antmicro/audio-latency-tester-board/assets/previews/layer1.png

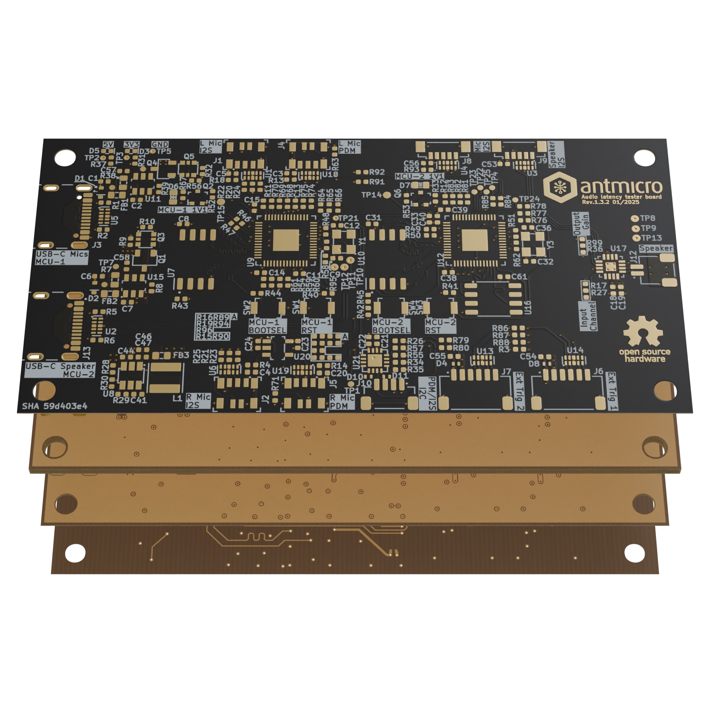
assets/previews/layer1.png
