antmicro/audio-latency-tester-board/assets/previews/layer2.png

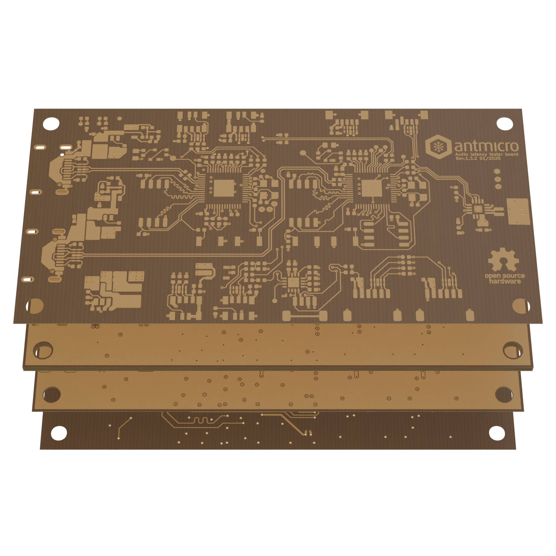
assets/previews/layer2.png
