antmicro/audio-latency-tester-board/assets/previews/layer3.png

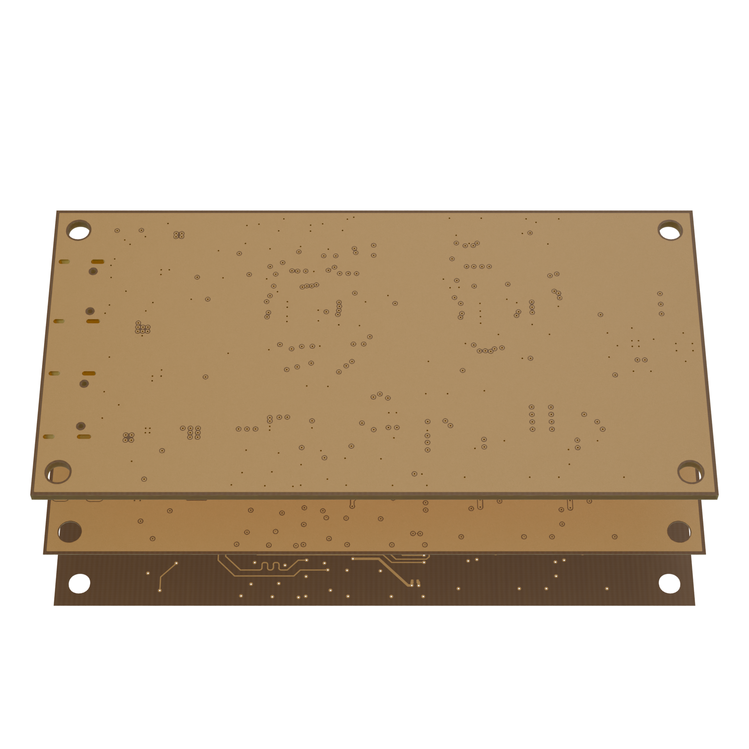
assets/previews/layer3.png
