antmicro/audio-latency-tester-board/assets/previews/layer3.webp

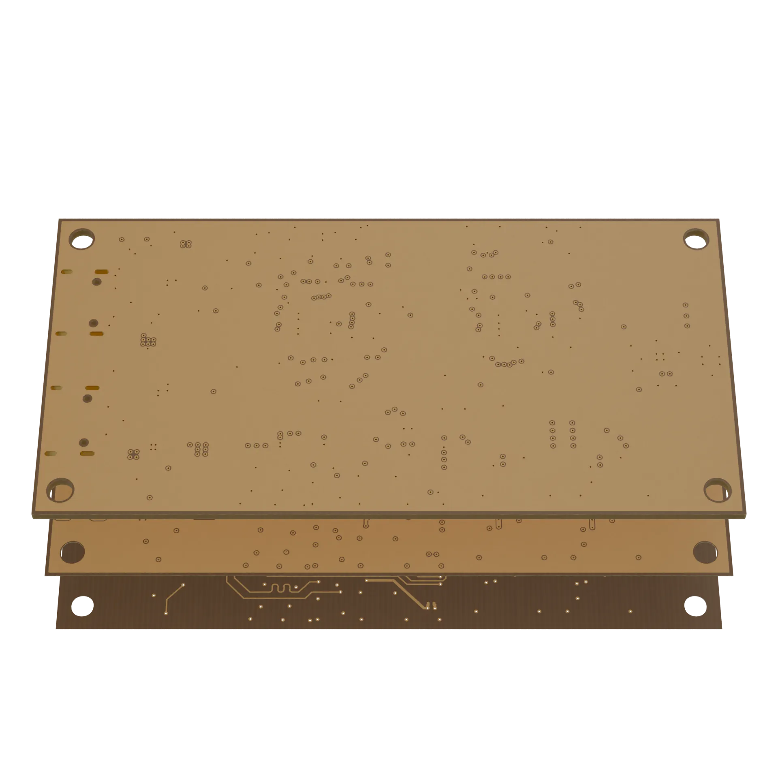
assets/previews/layer3.webp
