antmicro/audio-latency-tester-board/assets/previews/layer3_thumbnail.png

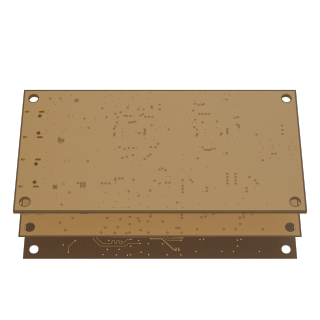
assets/previews/layer3_thumbnail.png
