antmicro/audio-latency-tester-board/assets/previews/layer4.png

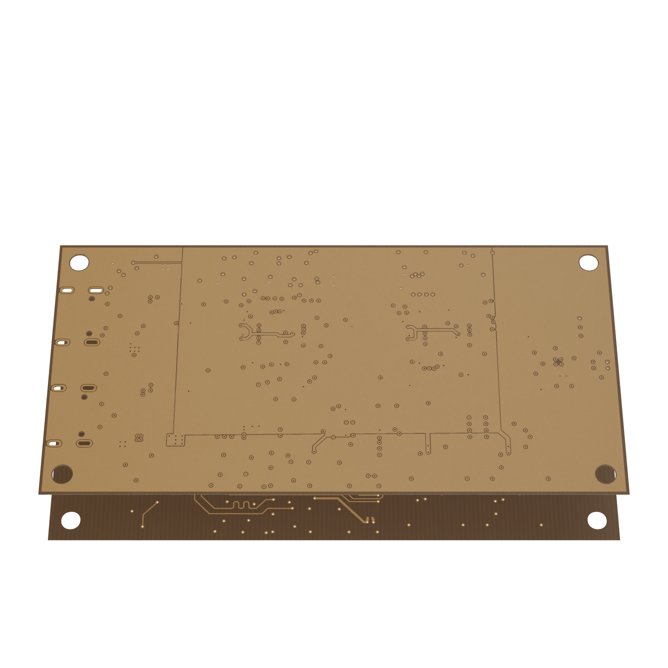
assets/previews/layer4.png
