antmicro/audio-latency-tester-board/assets/previews/layer4_thumbnail.webp

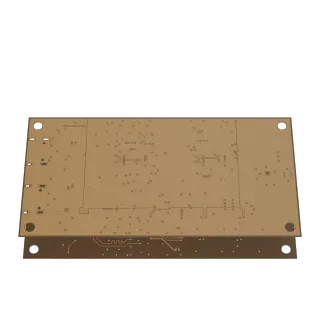
assets/previews/layer4_thumbnail.webp
