antmicro/audio-latency-tester-board/assets/previews/layer5.png

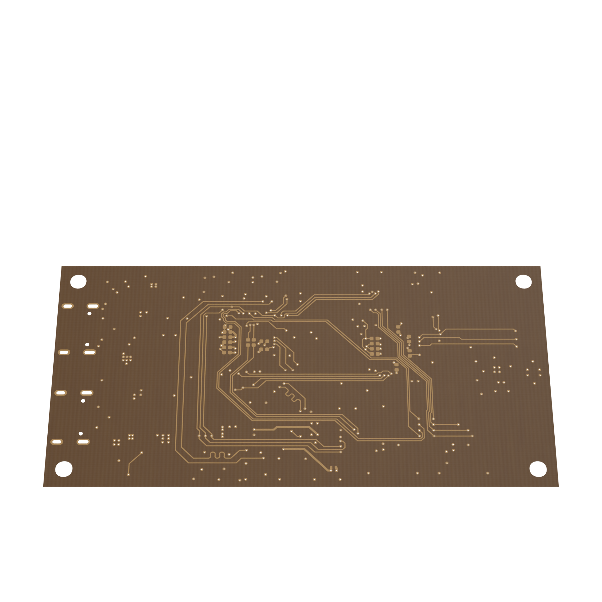
assets/previews/layer5.png
