antmicro/audio-latency-tester-board/assets/previews/leftB.png

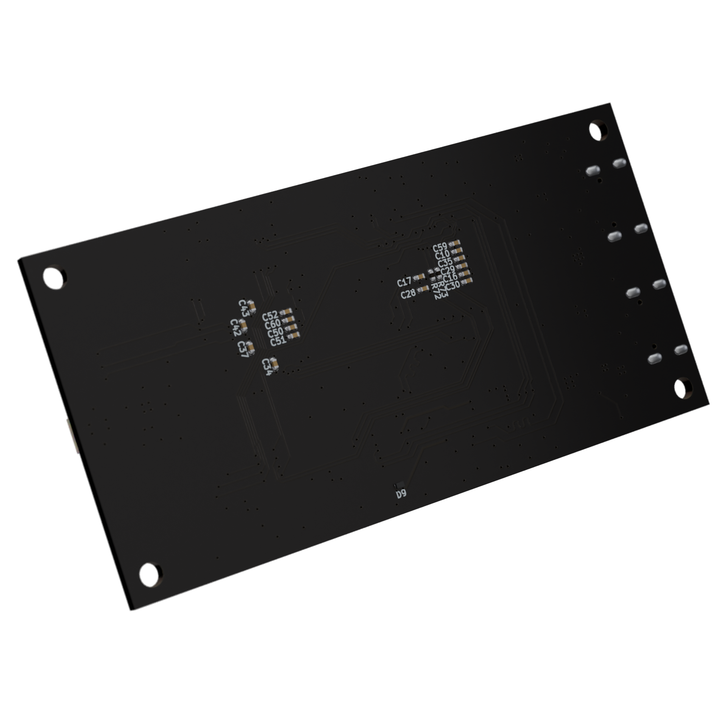
assets/previews/leftB.png
