antmicro/audio-latency-tester-board/assets/previews/leftT.png

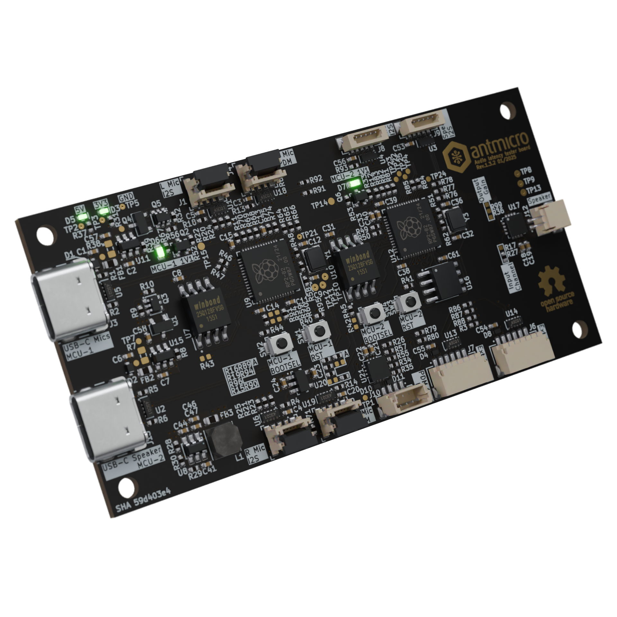
assets/previews/leftT.png
