antmicro/audio-latency-tester-board/assets/previews/orthoB.png

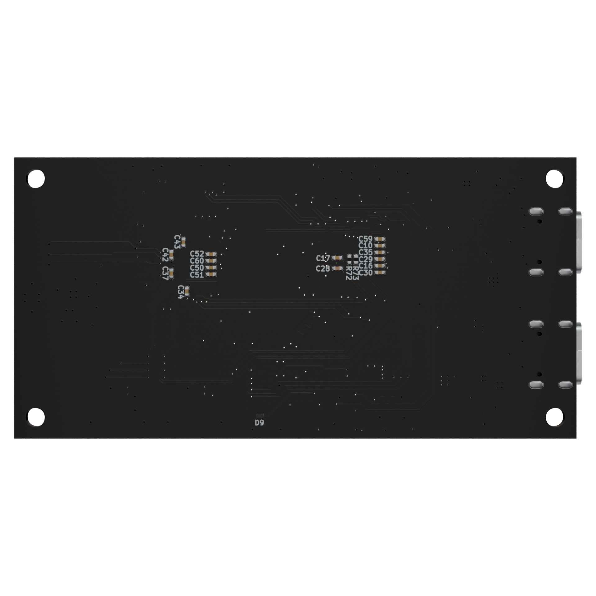
assets/previews/orthoB.png
