antmicro/audio-latency-tester-board/assets/previews/rightB.png

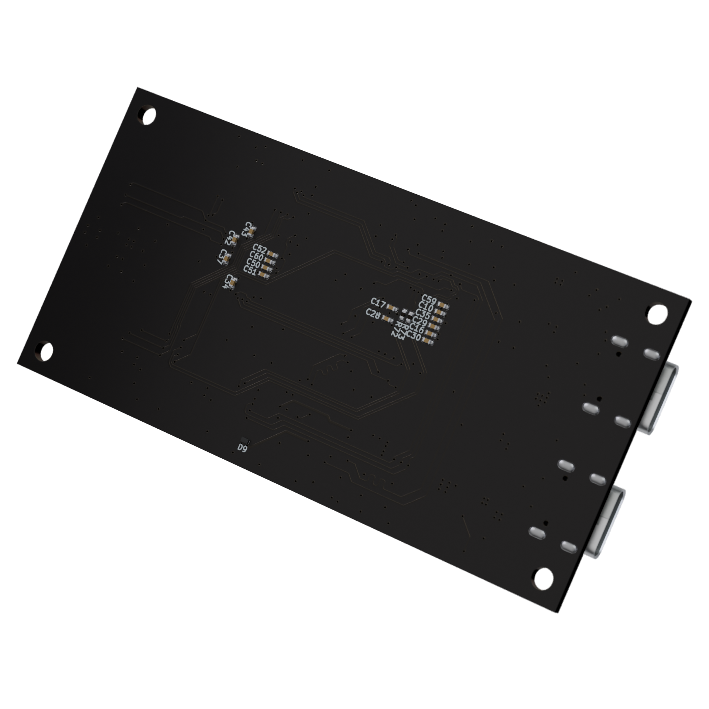
assets/previews/rightB.png
