antmicro/audio-latency-tester-board/assets/previews/rightT.png

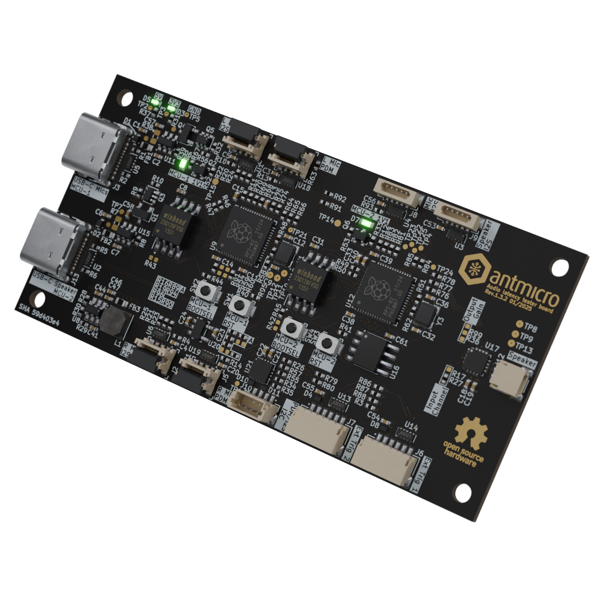
assets/previews/rightT.png
