antmicro/audio-latency-tester-board/assets/wireframe/wireframe_wireframe_dimensions.png

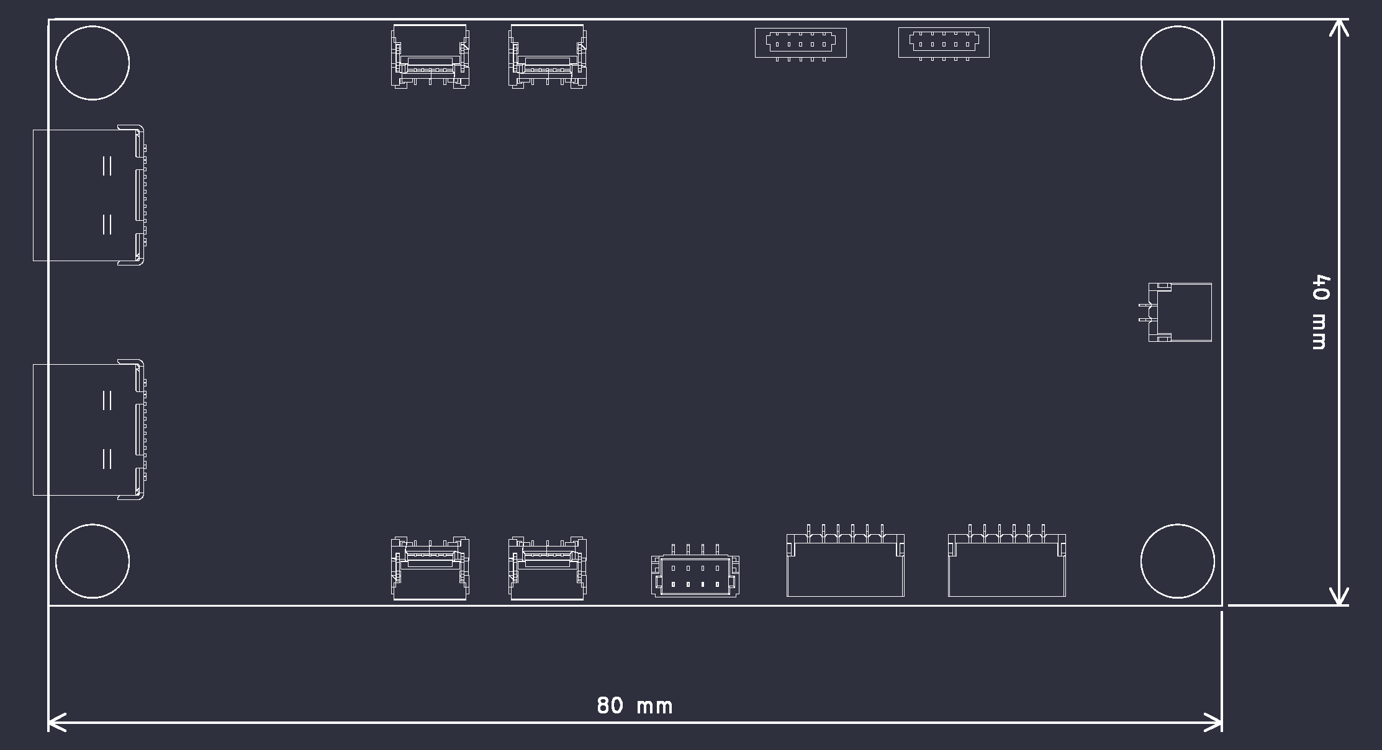
assets/wireframe/wireframe_wireframe_dimensions.png
