antmicro/audio-latency-tester-board/doc/audio-latency-tester-board-schematic.pdf

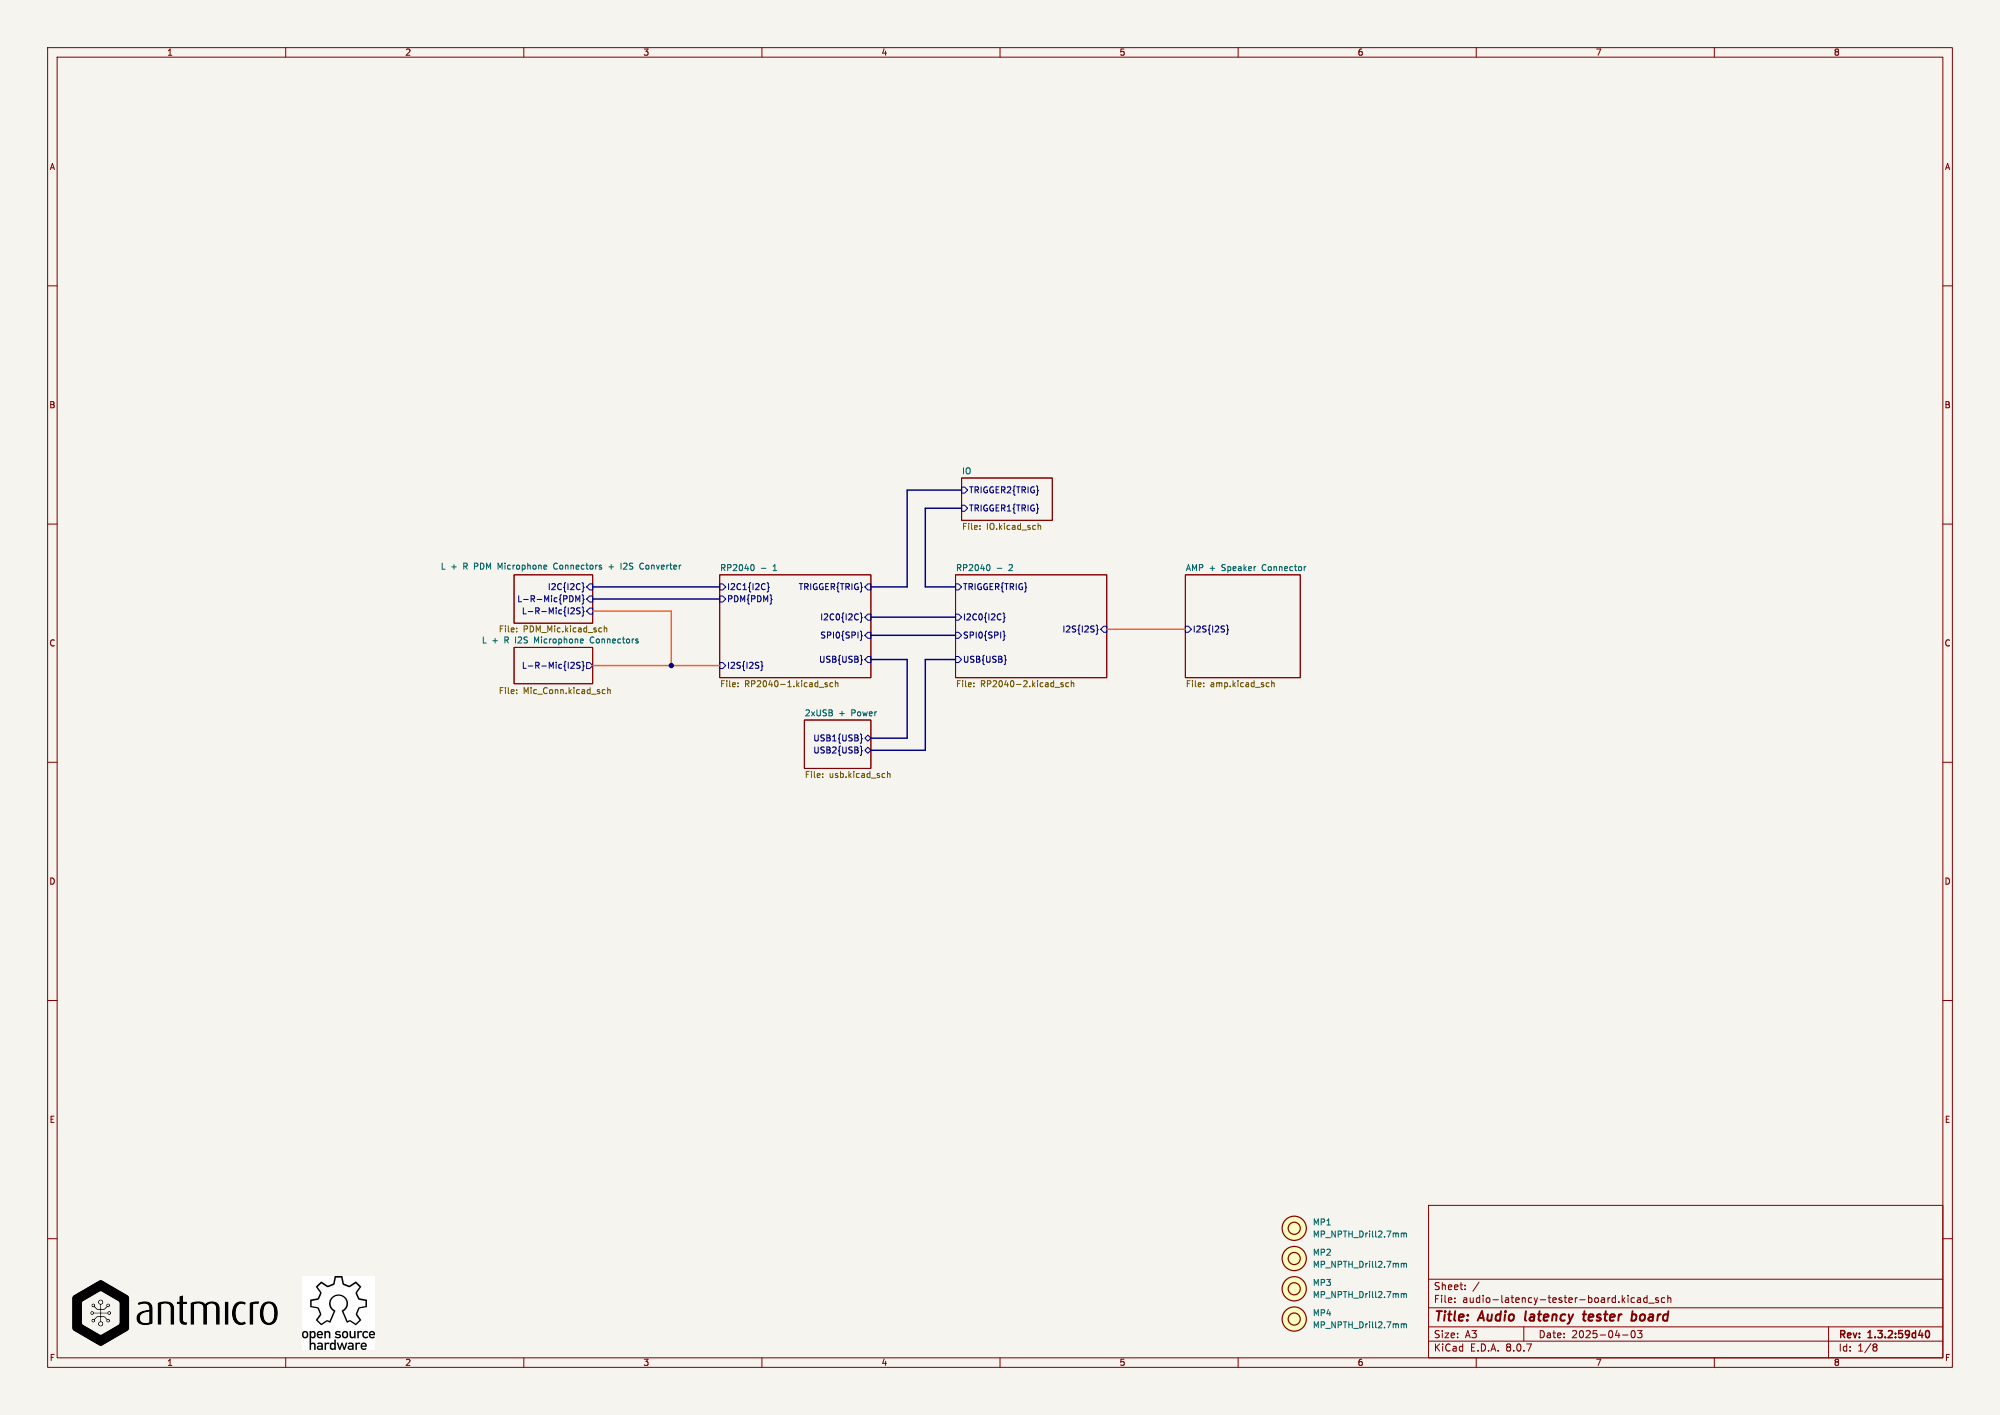
[picture p19: page 1]

I2S{I2S} AMP + Speaker Connector File: amp.kicad_sch

USB1{USB} 2xUSB + Power File: usb.kicad_sch

File: audio-latency-tester-board.kicad_sch Sheet: /
Id: 1/8 Title: Audio latency tester board

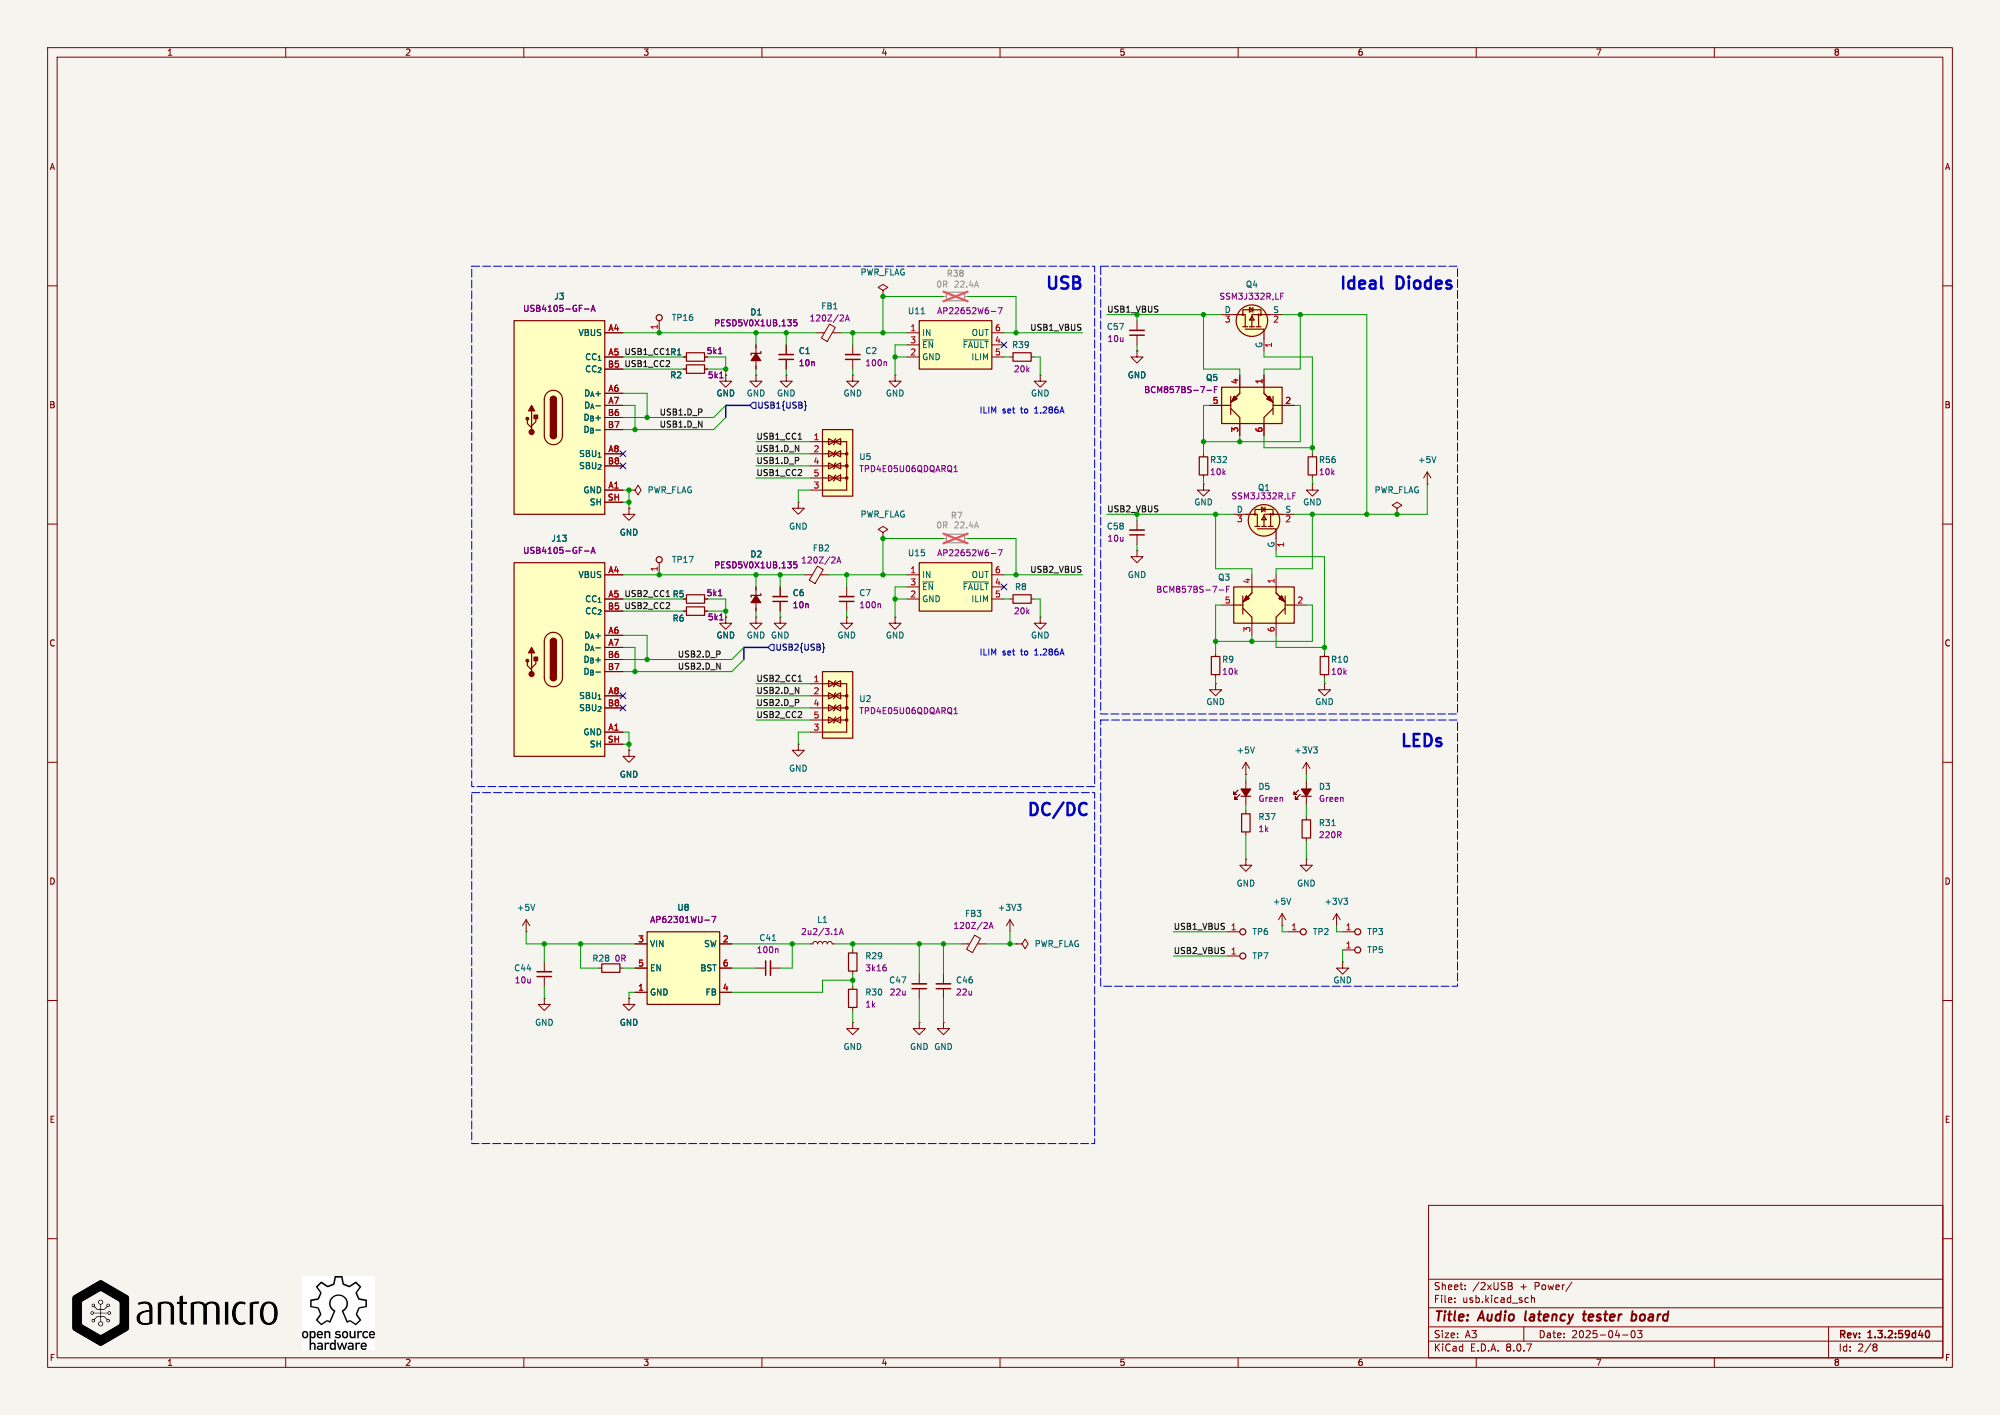
[picture p20: page 2]

PWR_FLAG
ILIM set to 1.286A USB

J13 USB4105-GF-A GND A1 VBUS A4 CC_{1}A5 D_{A}+A6 D_{A}-A7 SBU_{1}A8 CC_{2}B5 D_{B}+B6 D_{B}-B7 SBU_{2}B8 SH SH

J3 USB4105-GF-A GND A1 VBUS A4 CC_{1}A5 D_{A}+A6 D_{A}-A7 SBU_{1}A8 CC_{2}B5 D_{B}+B6 D_{B}-B7 SBU_{2}B8 SH SH

J13 USB4105-GF-A GND A1 VBUS A4 CC_{1}A5 D_{A}+A6 D_{A}-A7 SBU_{1}A8 CC_{2}B5 D_{B}+B6 D_{B}-B7 SBU_{2}B8 SH SHGND

+3V3 GND A1 VBUS A4 CC_{1}A5 D_{A}+A6 D_{A}-A7 SBU_{1}A8 CC_{2}B5 D_{B}+B6 D_{B}-B7 SBU_{2}B8 SH SH

Id: 2/8 Title: Audio latency tester board

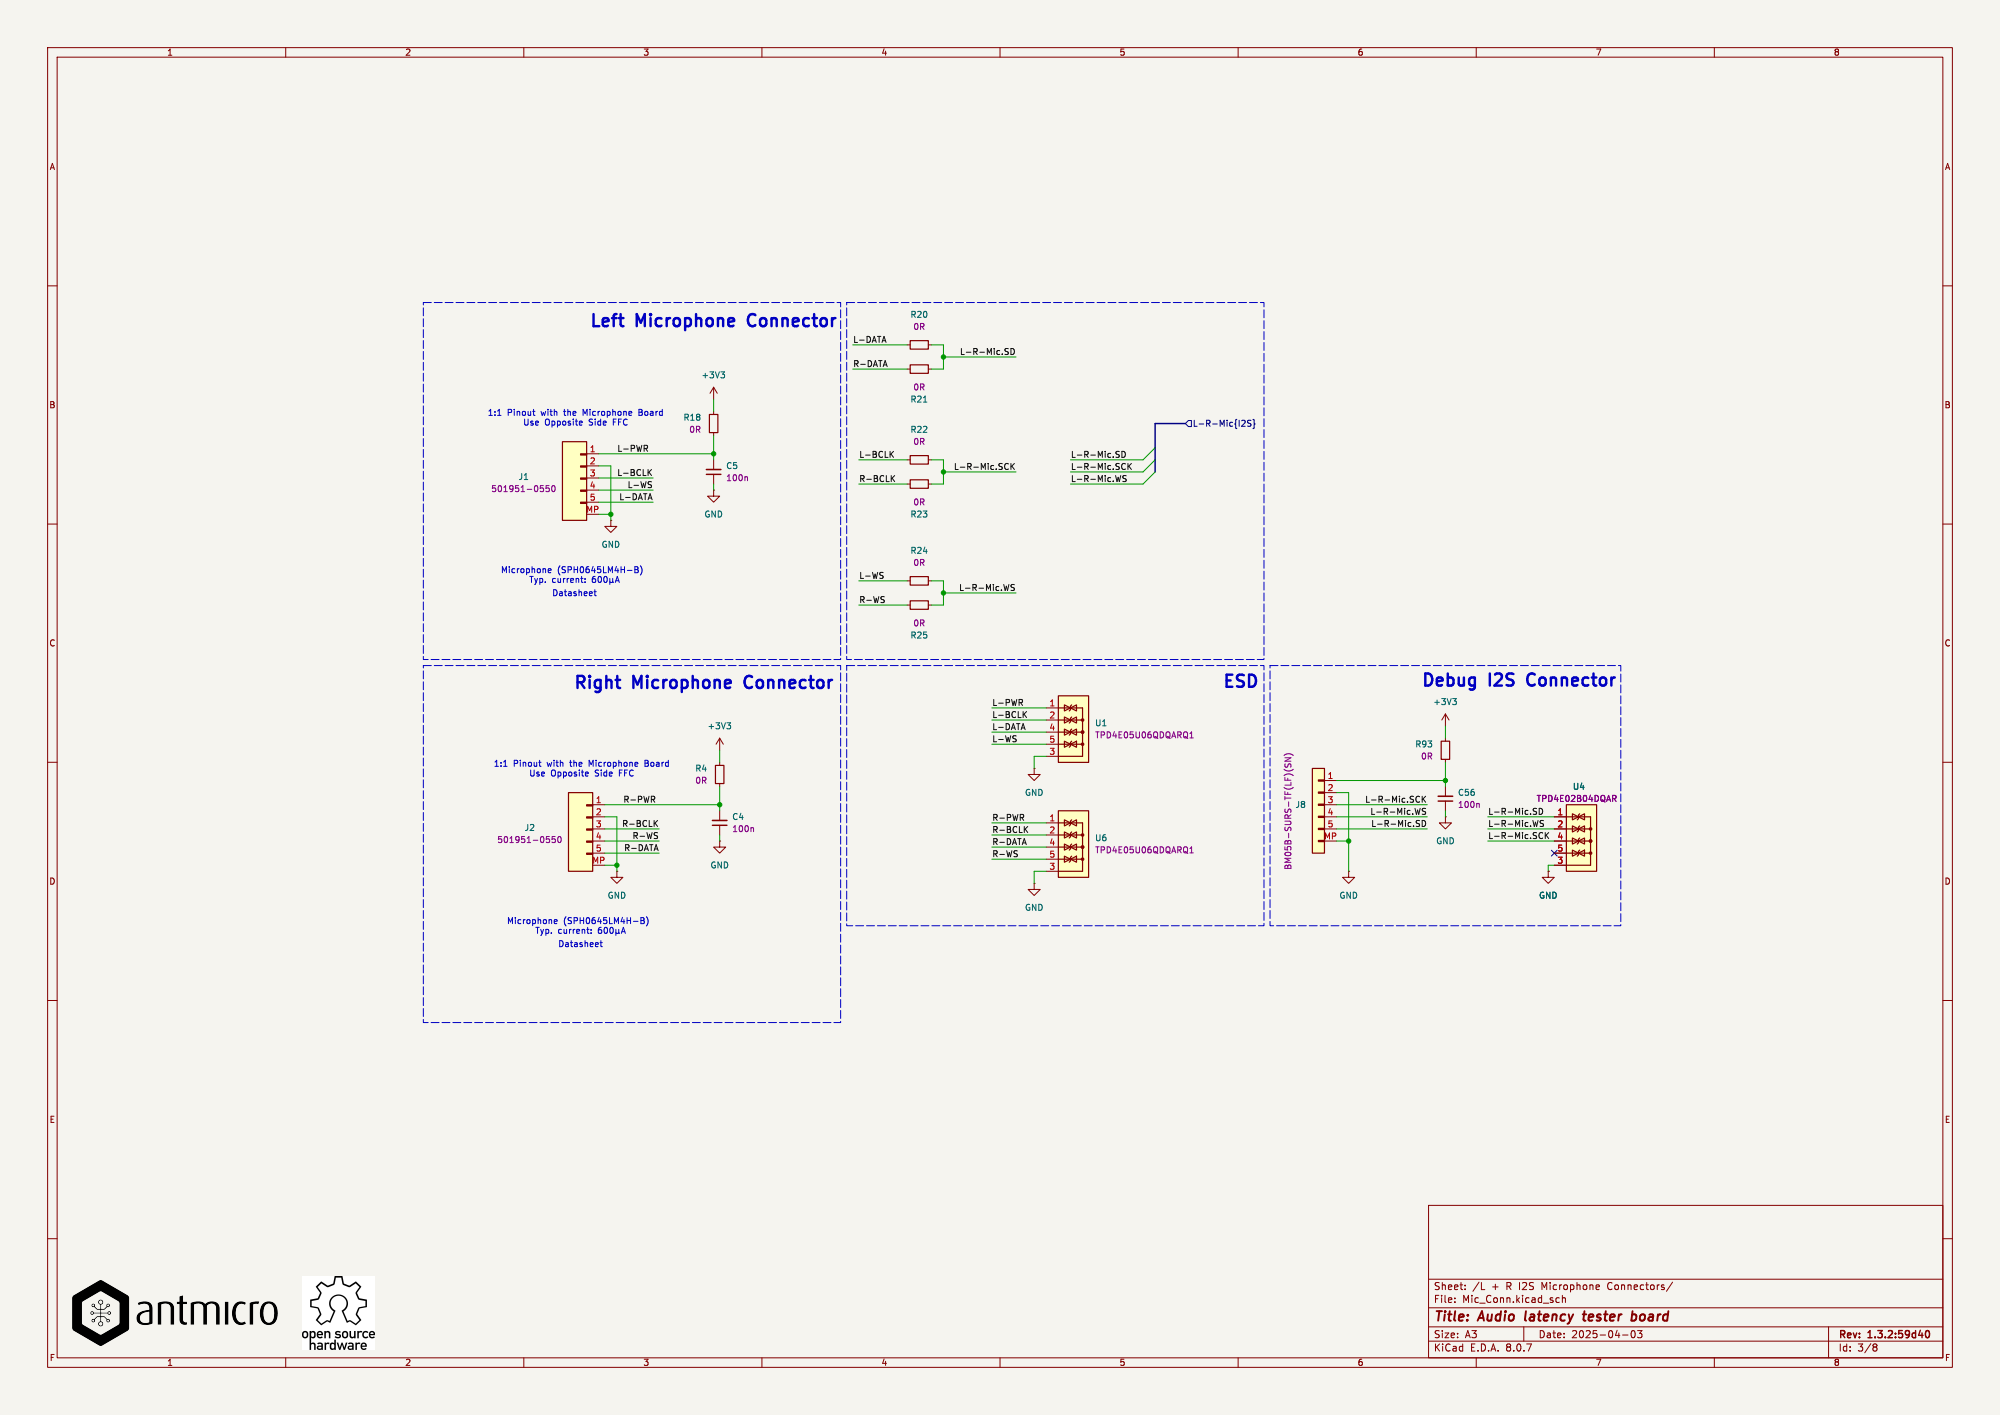
[picture p21: page 3]

L-R-Mic.SD
L-R-Mic.SCKR-DATA R-PWR

L-R-Mic.WS R-WS R-BCLK

L-R-Mic.WS Debug I2S Connector

Id: 3/8 Title: Audio latency tester board

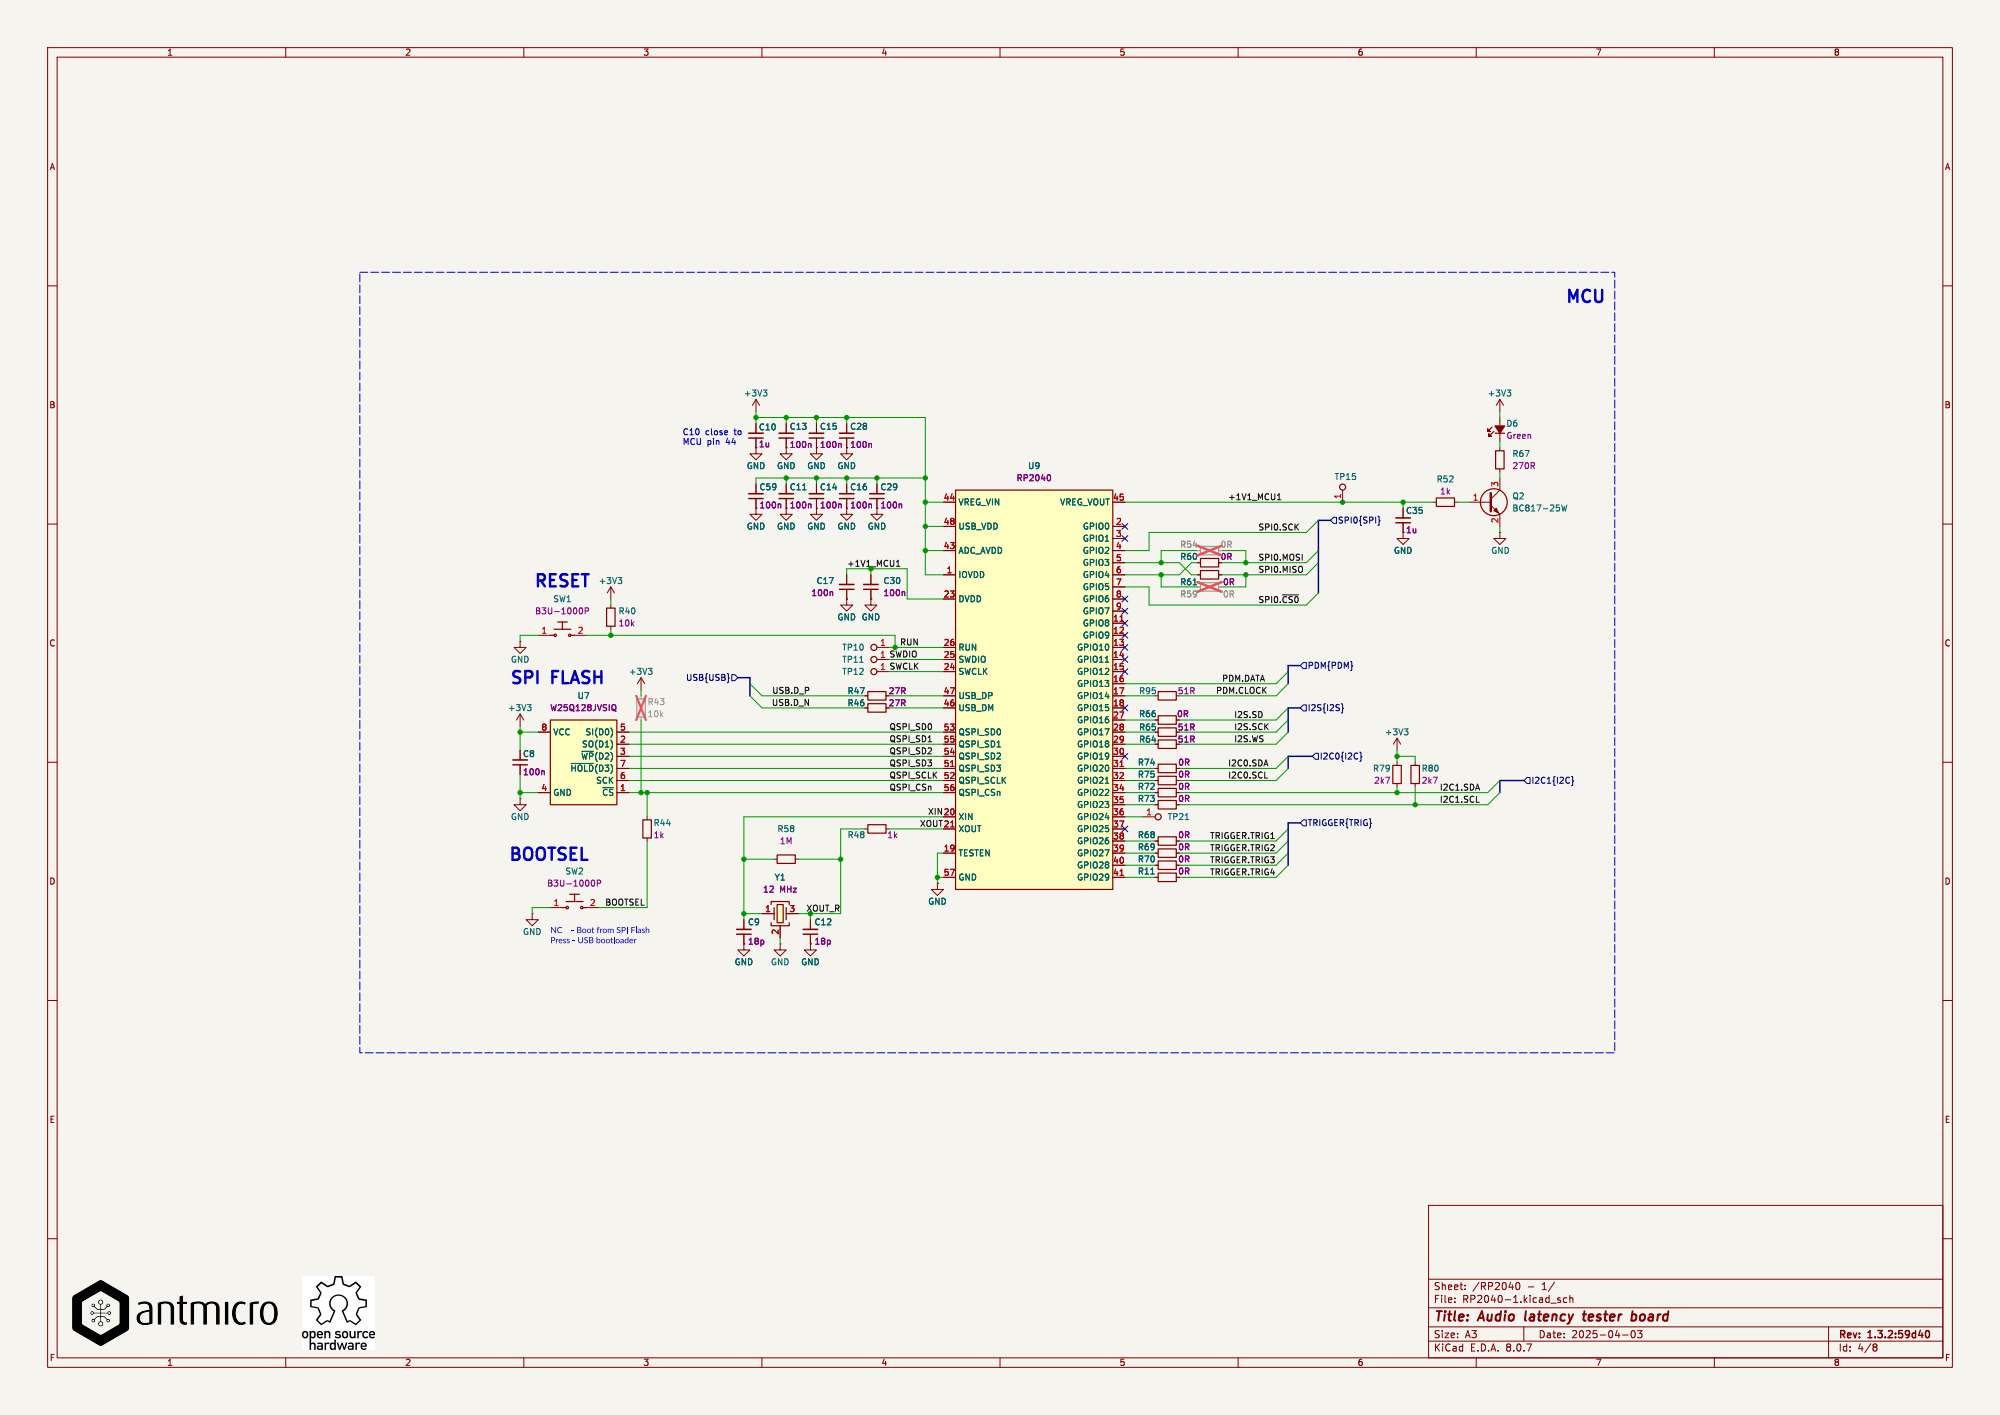
[picture p22: page 4]

C10 close to MCU pin 44 RESET

SPI0.MISO
TRIGGER.TRIG3 TRIGGER.TRIG2 PDM.CLOCK

Id: 4/8 Title: Audio latency tester board

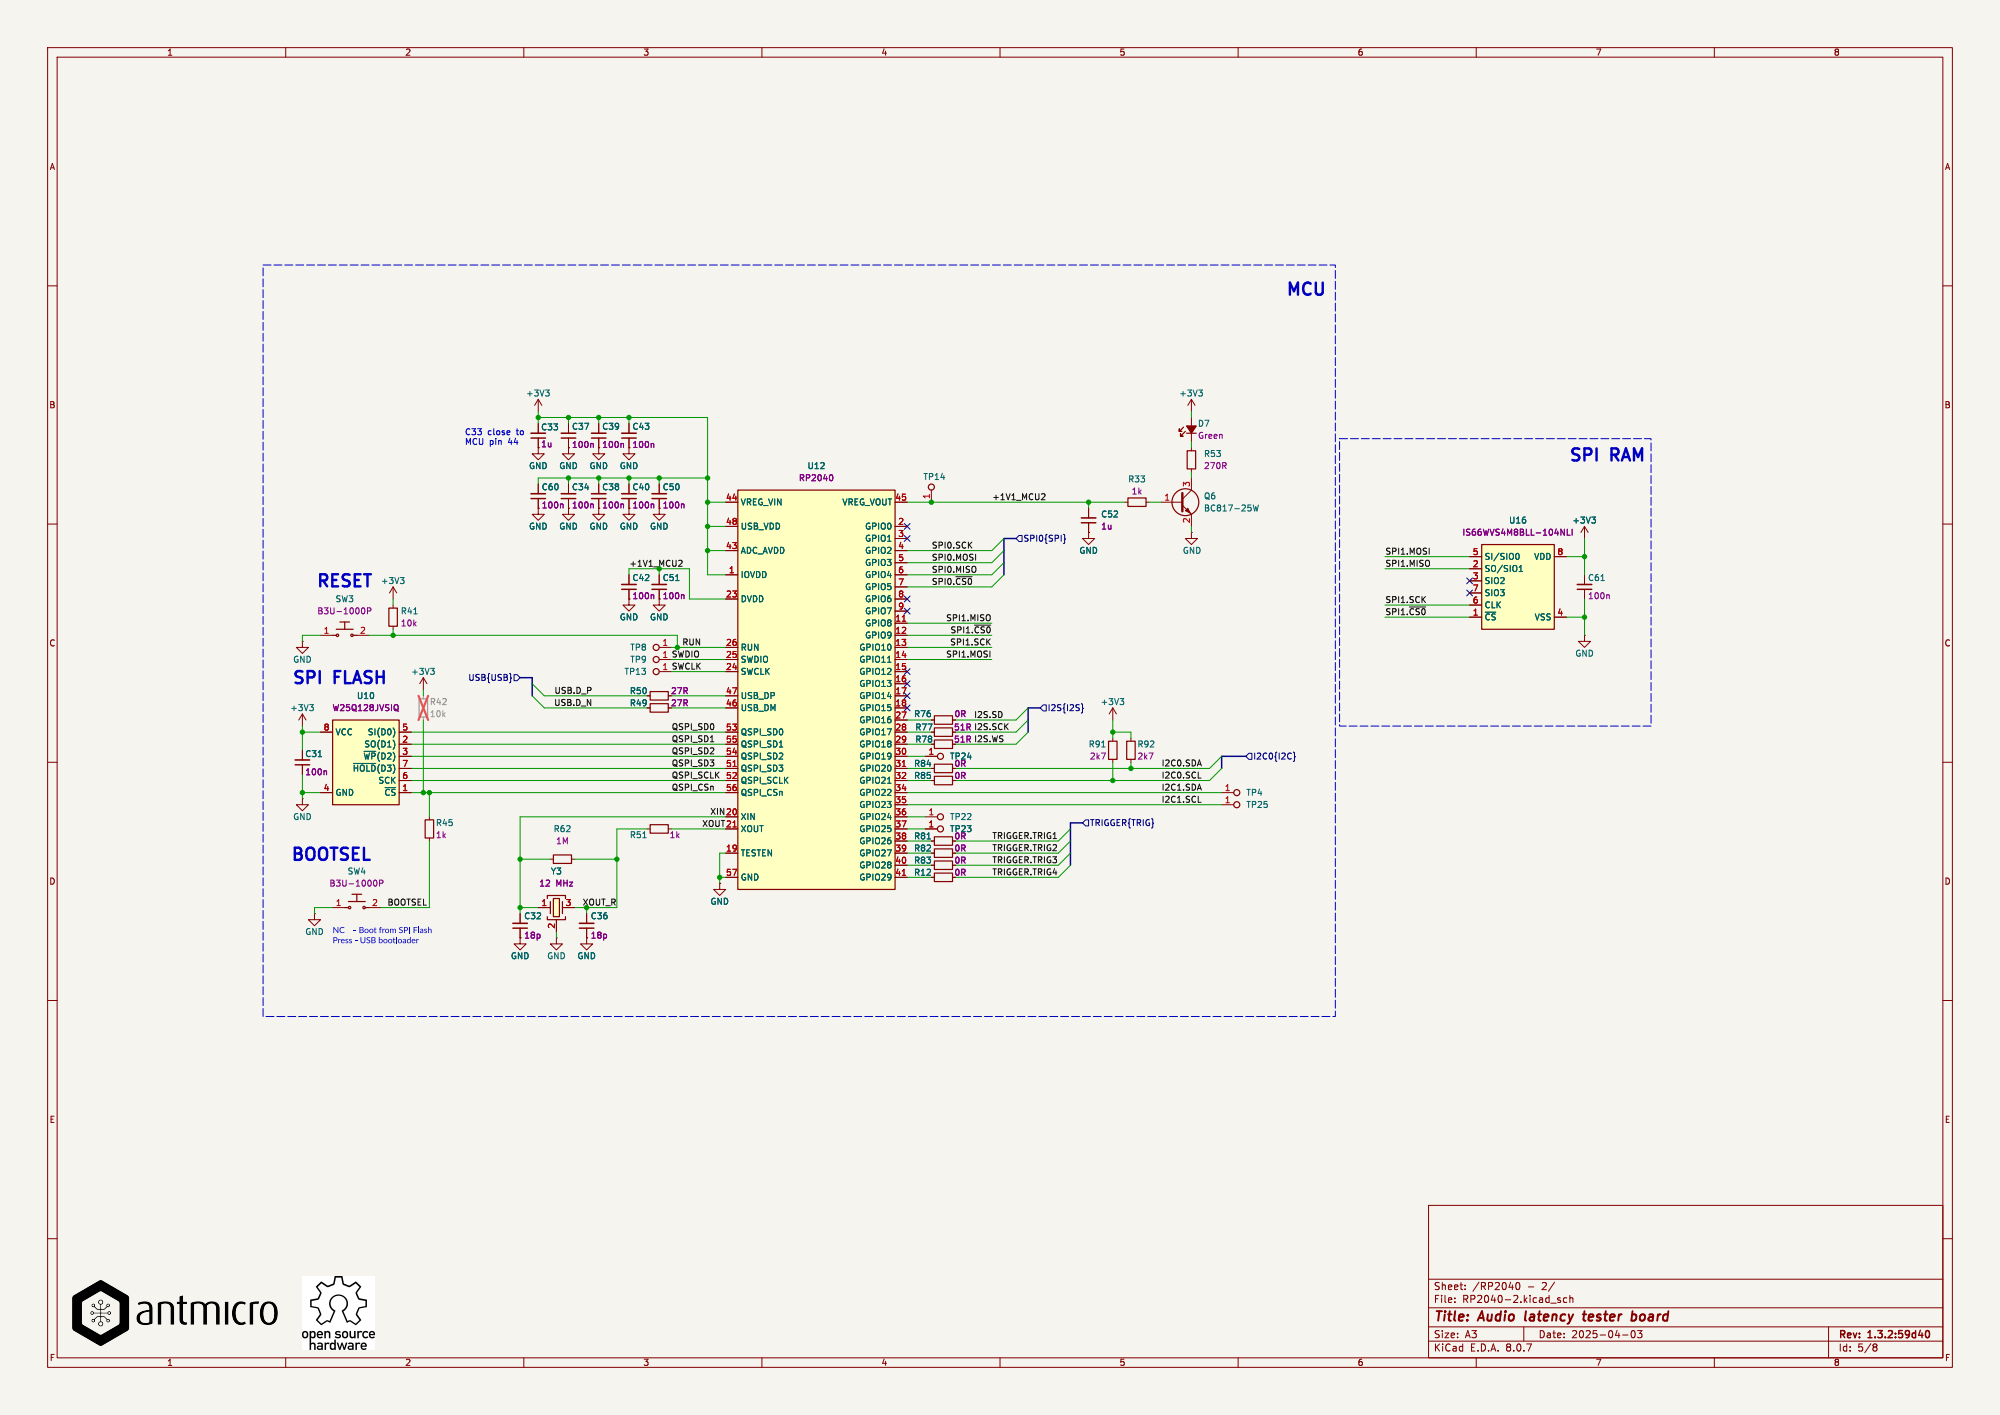
[picture p23: page 5]

NC - Boot from SPIFlash Press- USBbootloader SPI FLASH

Id: 5/8 Title: Audio latency tester board

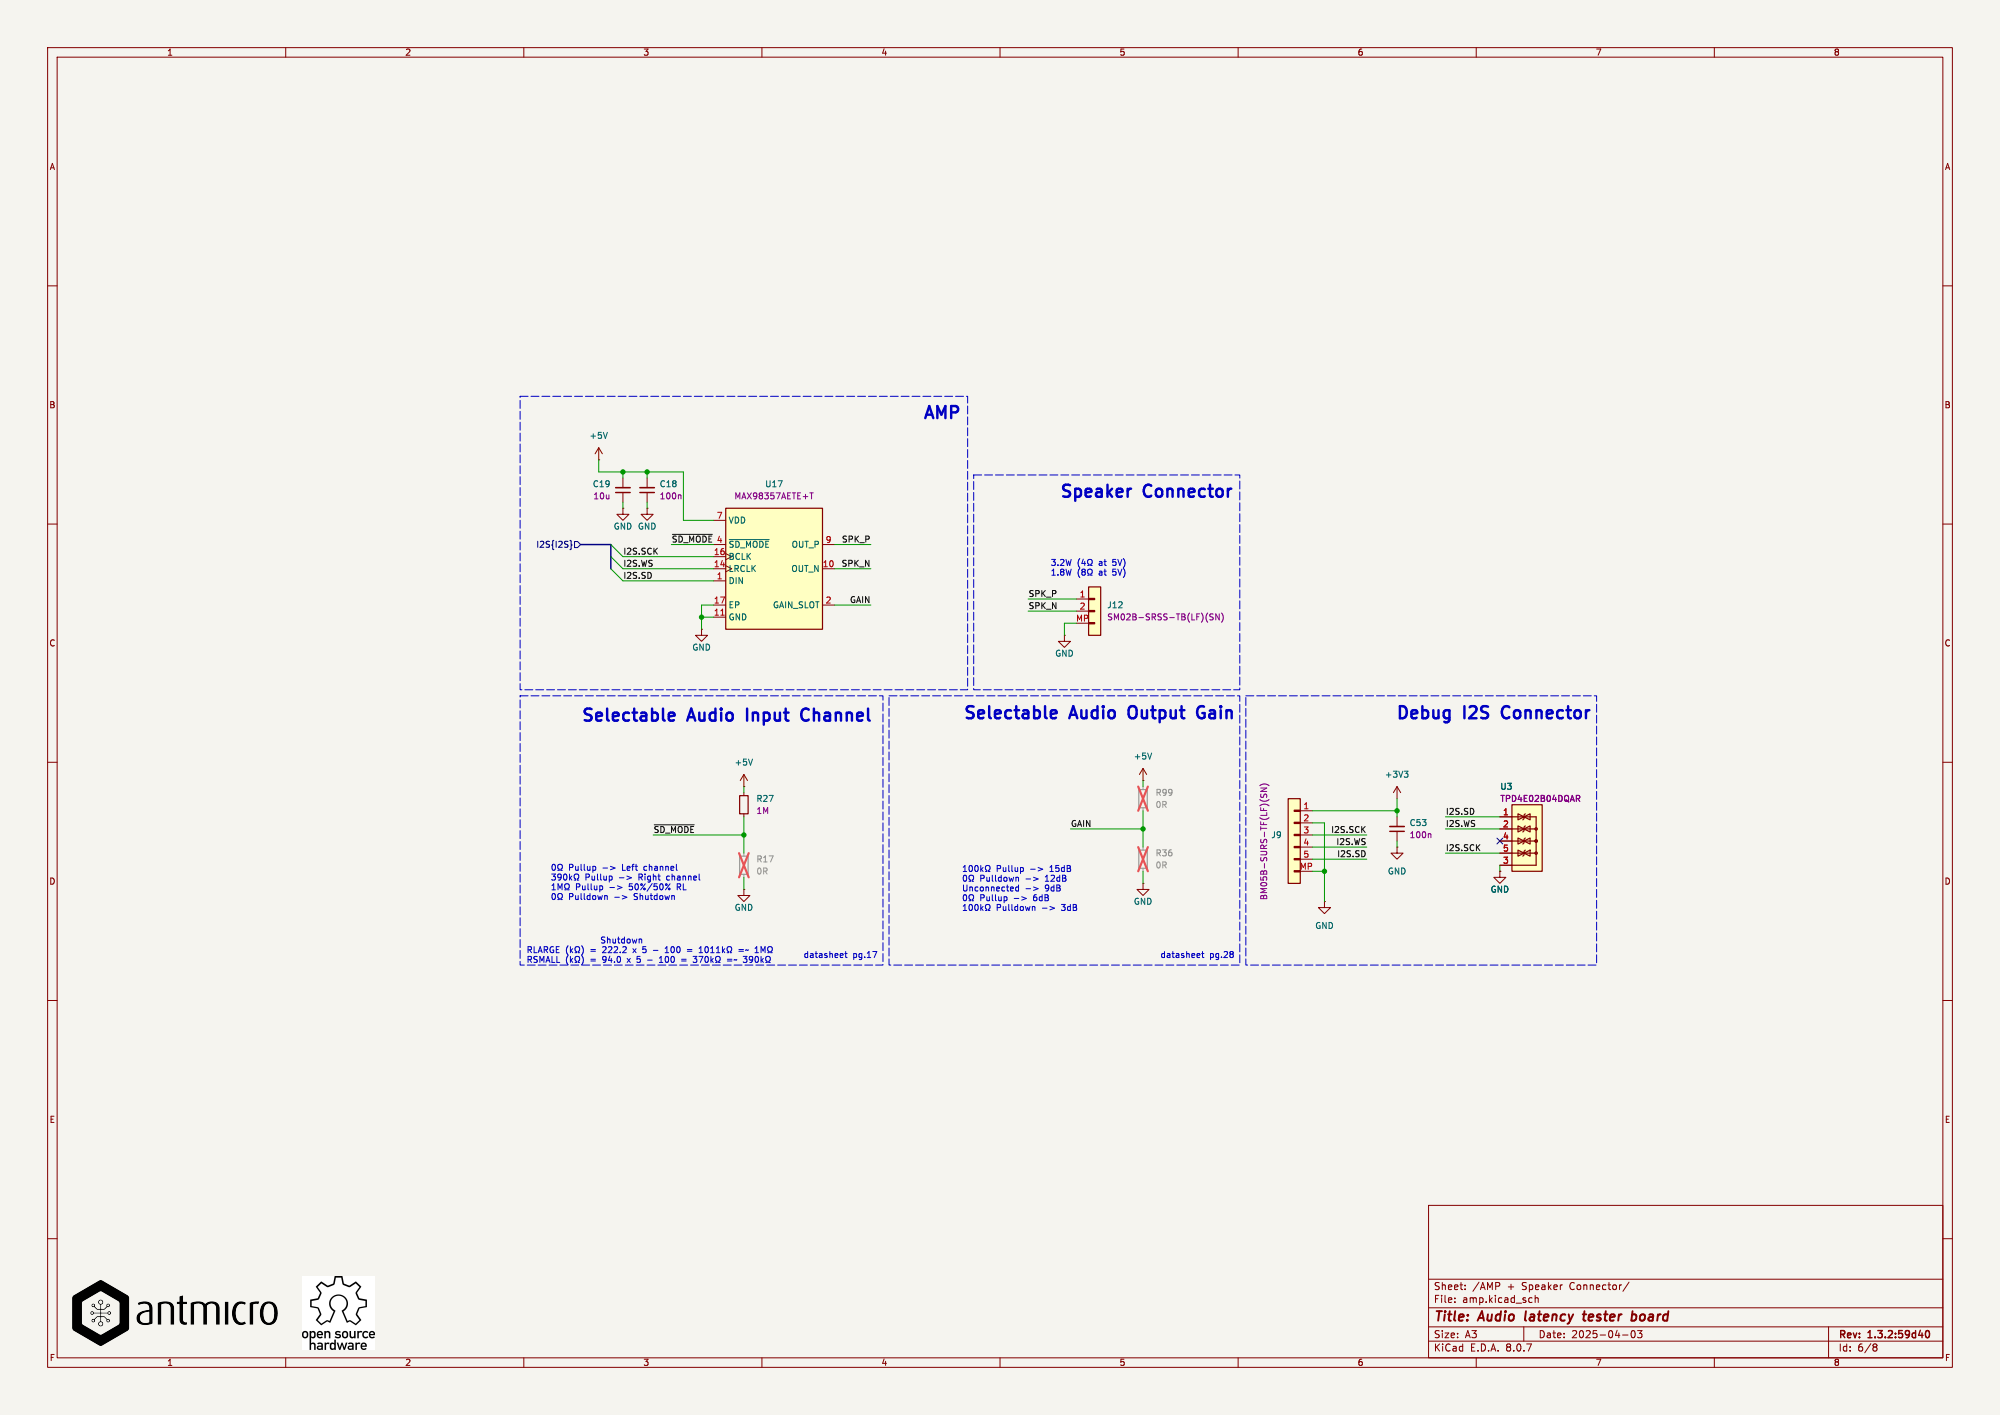
[picture p24: page 6]

J12 SM02B-SRSS-TB(LF)(SN) GND GND GND

RSMALL þÿ(k©) = 94.0 x 5 - 100 = þÿ370k©=~ þÿ390k©

File: amp.kicad_sch Sheet: /AMP + Speaker Connector/
Id: 6/8 Title: Audio latency tester board

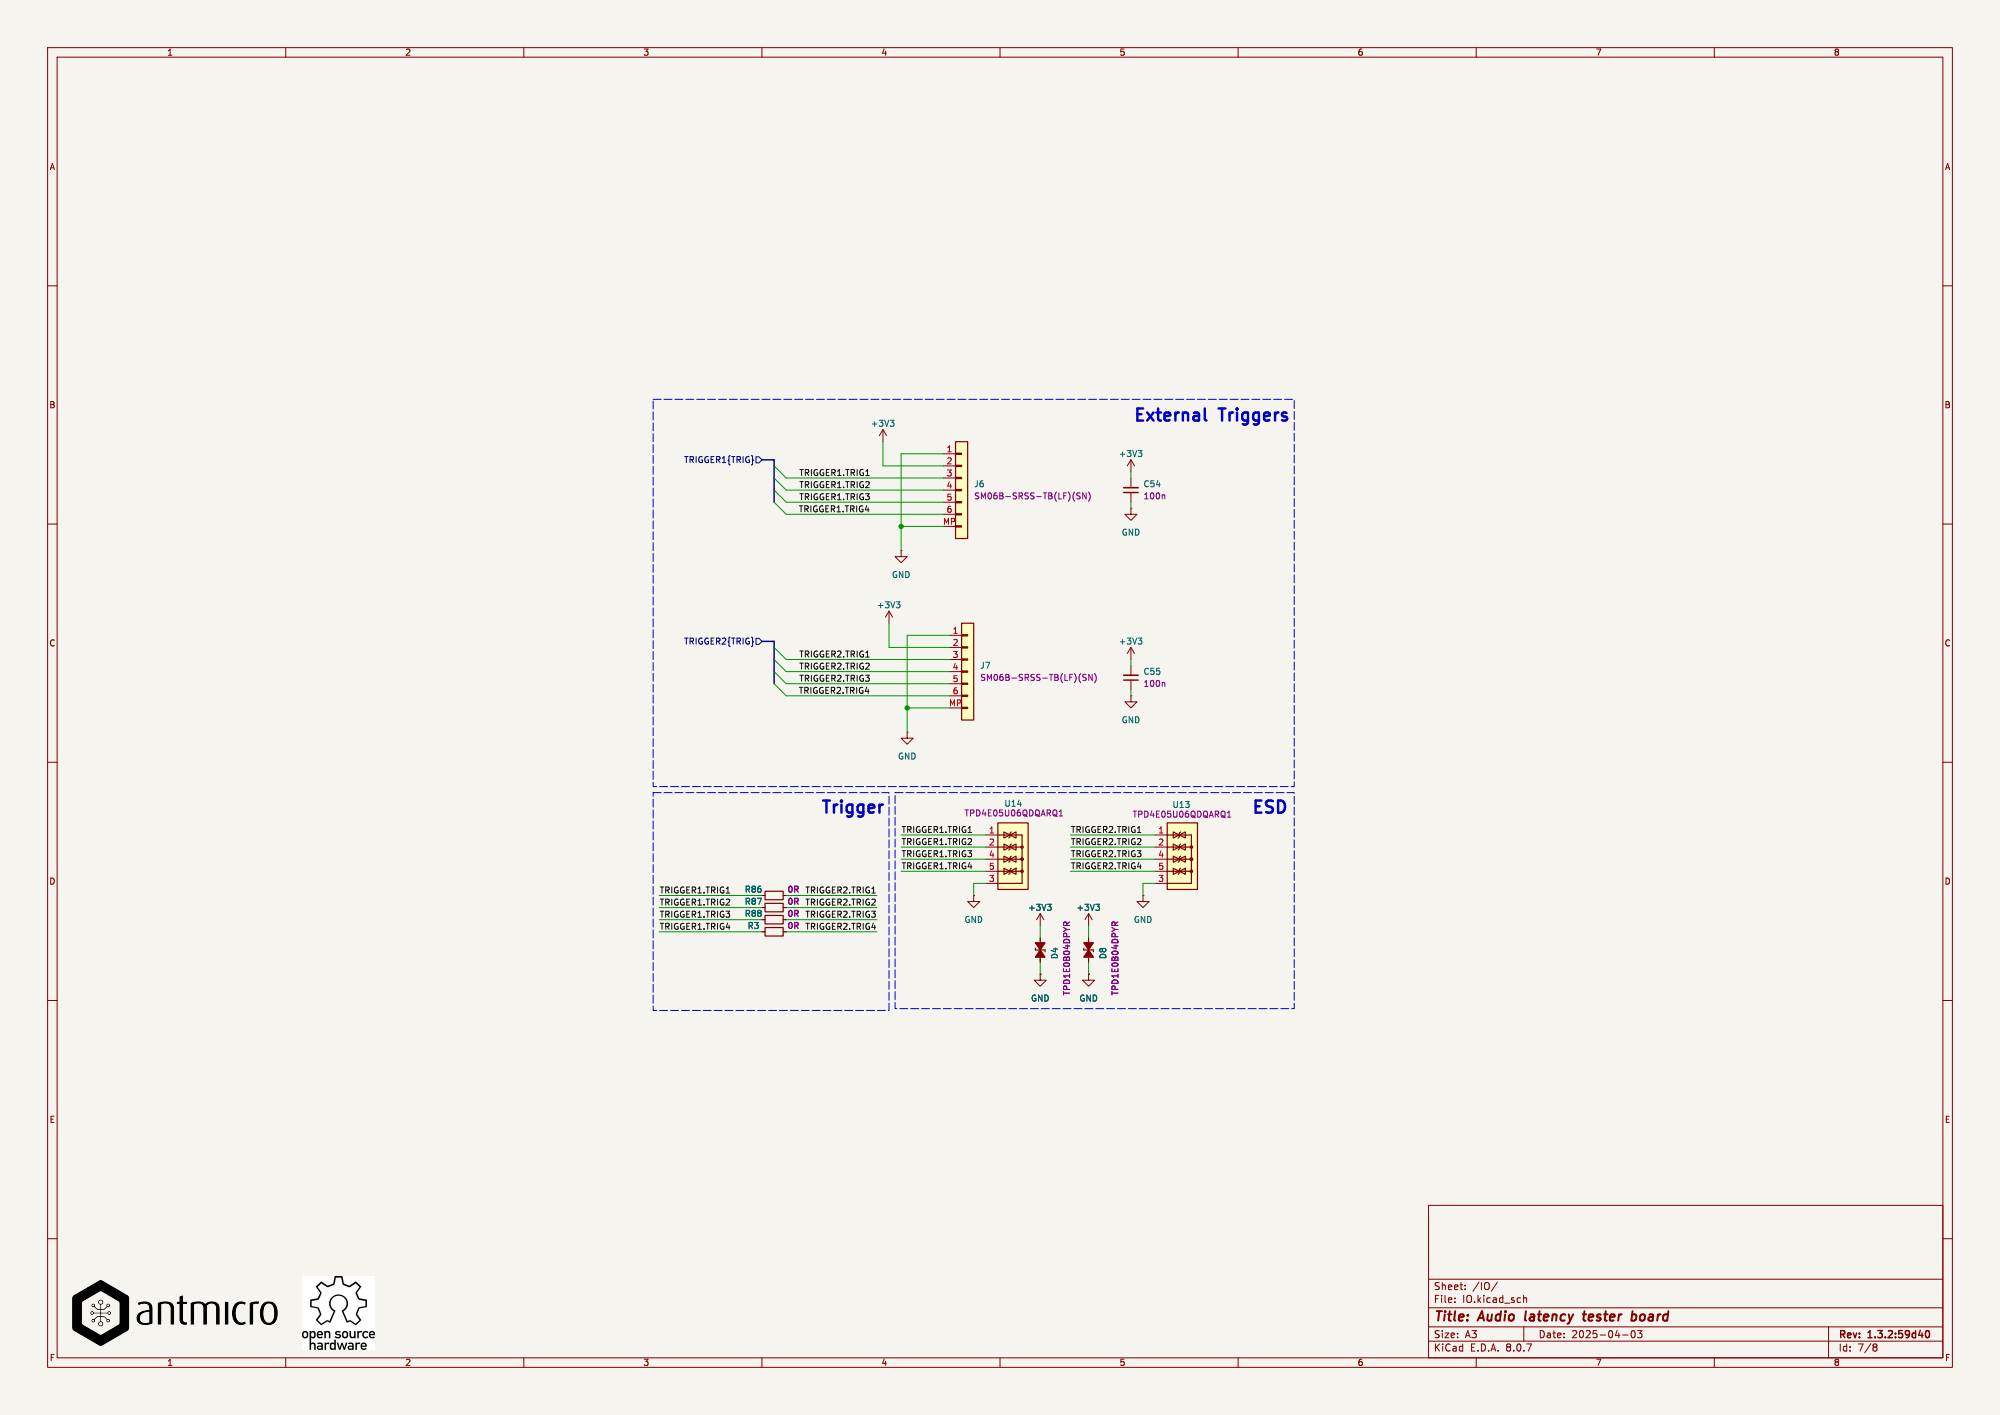
[picture p25: page 7]

Id: 7/8 Title: Audio latency tester board

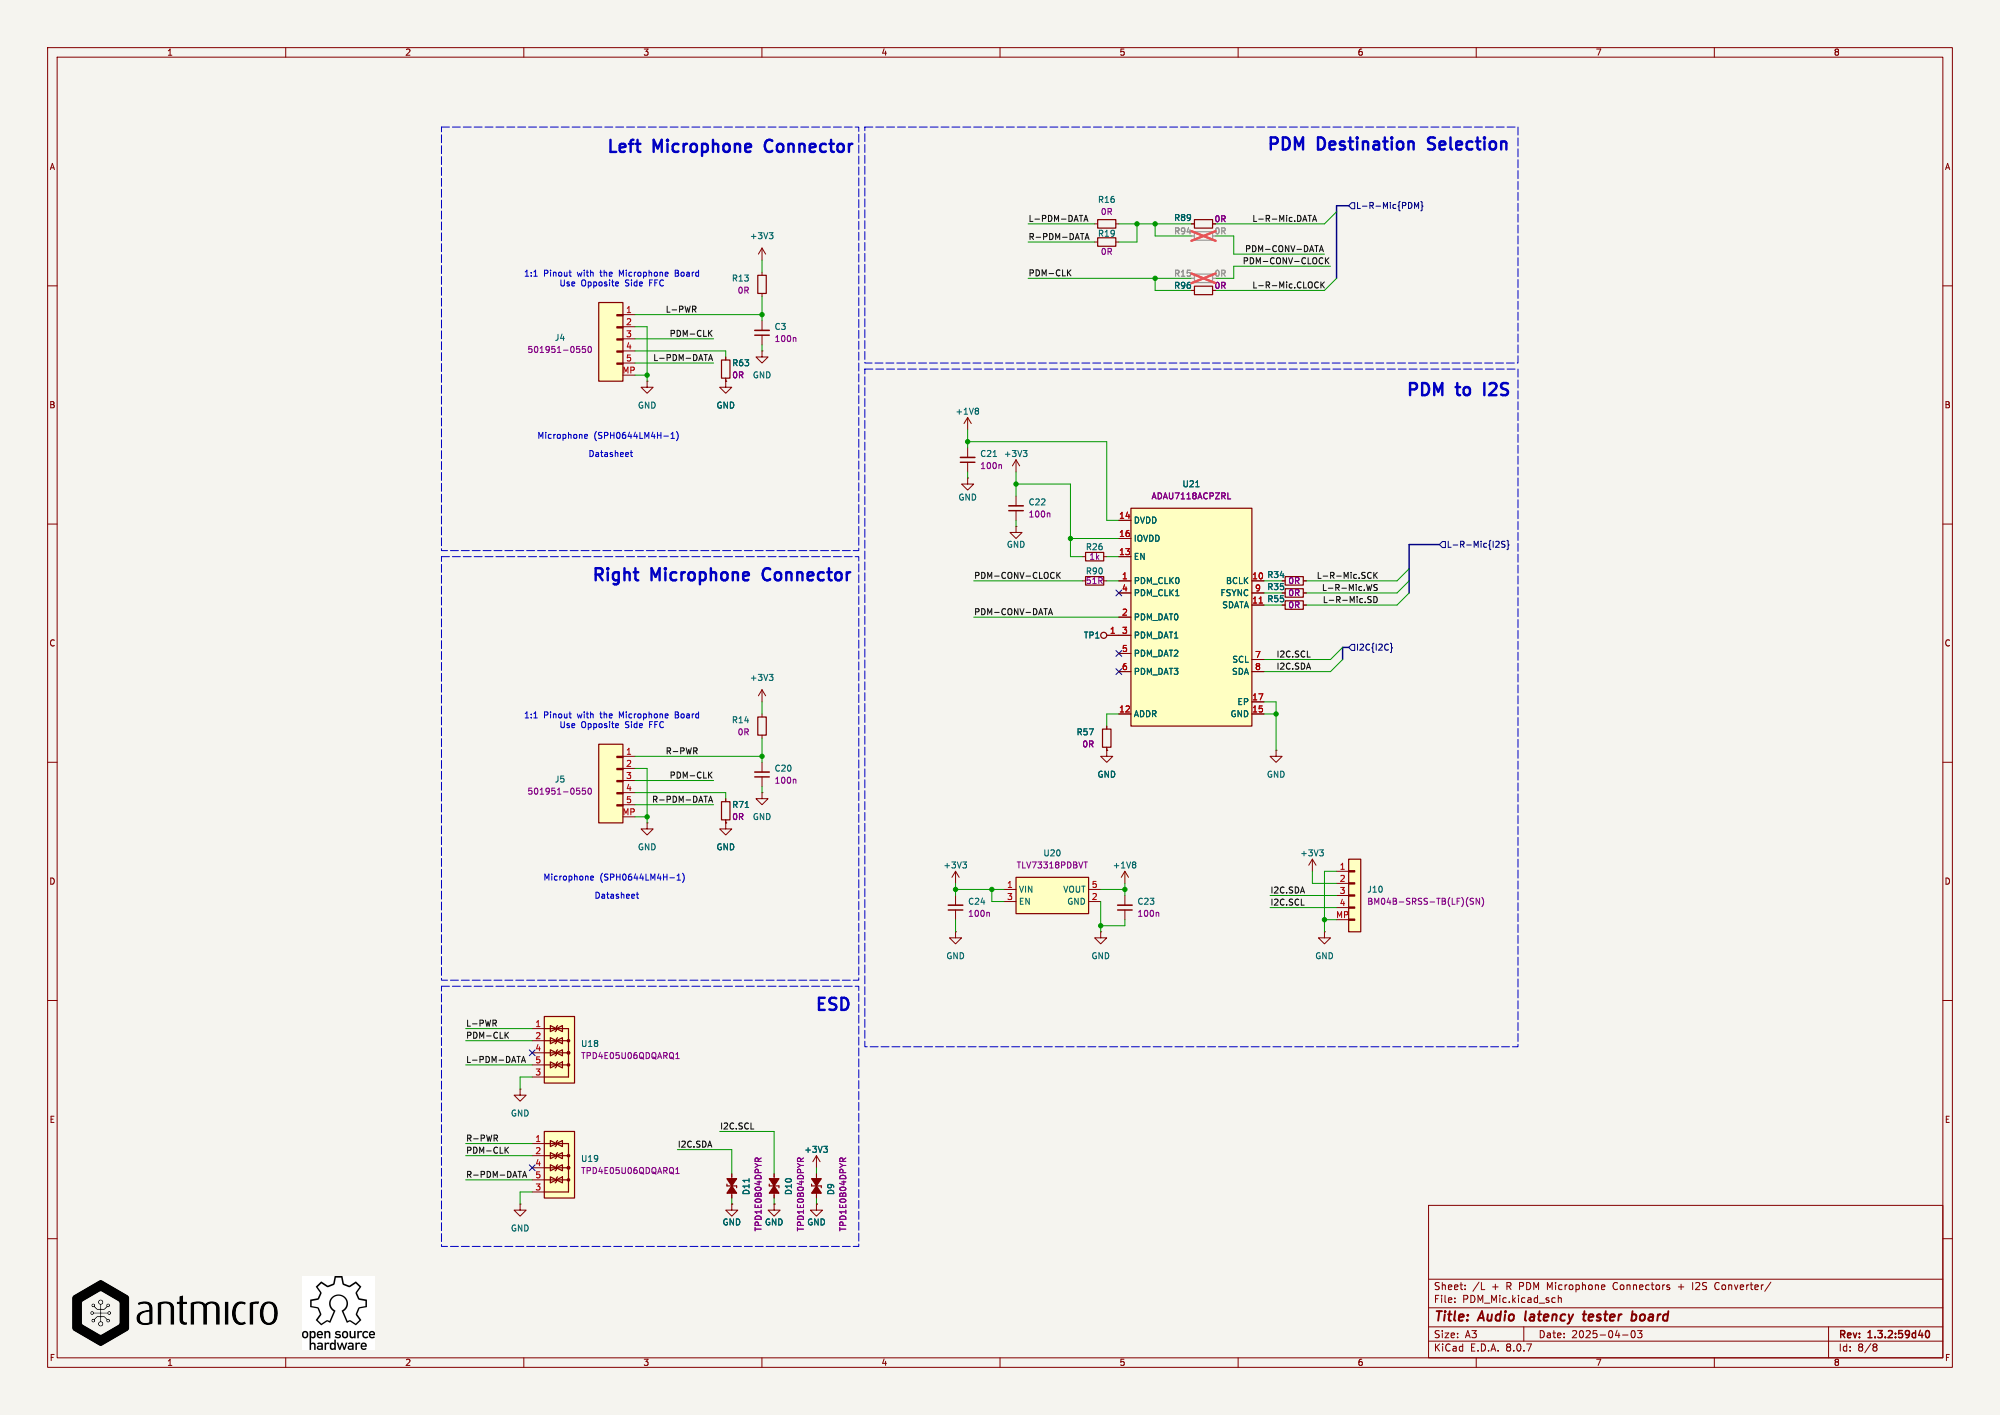
[picture p26: page 8]

L-PDM-DATA
PDM-CLK R-PDM-DATA

Id: 8/8 Title: Audio latency tester board
