antmicro/audio-latency-tester-board/(commit log)

2025-04-04 [#71041] Add kicad project
    [audio-latency-processing-board.kicad_pcb, audio-latency-processing-board.kicad_sch]
2025-04-04 [#71107] Design initial schematic
    [IO.kicad_sch, L_ear_conn.kicad_sch, R_ear_conn.kicad_sch, adc.kicad_sch, amp.kicad_sch, audio-latency-processing-board.kicad_sch, speaker_conn.kicad_sch, usb.kicad_sch]
2025-04-04 [#71107] Rename project to audio-latency-processing-board
2025-04-04 [#71555] Add new root sheet structure
    [IO.kicad_sch, L_ear_conn.kicad_sch, Mic_Conn.kicad_sch, RP2040-1.kicad_sch, RP2040-2.kicad_sch, adc.kicad_sch, amp.kicad_sch, audio-latency-processing-board.kicad_sch]
2025-04-04 [#71555] Draw MIC and USB Connector sheets
    [Mic_Conn.kicad_sch, usb.kicad_sch]
2025-04-04 [#71555] Add 2 x RP2040 sheets
    [RP2040-1.kicad_sch, RP2040-2.kicad_sch]
2025-04-04 [#71555] Prepare sch for AMP
    [amp.kicad_sch, usb.kicad_sch]
2025-04-04 [#71555] Add connections between RP2040s
    [IO.kicad_sch, Mic_Conn.kicad_sch, RP2040-1.kicad_sch, RP2040-2.kicad_sch, amp.kicad_sch, audio-latency-processing-board.kicad_sch, usb.kicad_sch]
2025-04-04 [#71555] Resolve ERC
    [IO.kicad_sch, Mic_Conn.kicad_sch, RP2040-1.kicad_sch, RP2040-2.kicad_sch, amp.kicad_sch, audio-latency-processing-board.kicad_sch, usb.kicad_sch]
2025-04-04 [#71555] Add debug I2S conn
    [Mic_Conn.kicad_sch, RP2040-1.kicad_sch, amp.kicad_sch]
2025-04-04 [#71555] Finish SPI Flash schematic
    [RP2040-2.kicad_sch]
2025-04-04 [#71555] Unify sheets
    [IO.kicad_sch, Mic_Conn.kicad_sch, RP2040-1.kicad_sch, RP2040-2.kicad_sch, amp.kicad_sch, audio-latency-processing-board.kicad_sch, usb.kicad_sch]
2025-04-04 [#71555] Add PCB SHA
2025-04-04 [#71555] Add missing connectors silk names
2025-04-04 [#71555] Fix page numbering
    [audio-latency-processing-board.kicad_sch]
2025-04-04 [#71555] Remove dash from sch names
    [IO.kicad_sch, Mic_Conn.kicad_sch, RP2040-1.kicad_sch, RP2040-2.kicad_sch, amp.kicad_sch, audio-latency-processing-board.kicad_sch, usb.kicad_sch]
2025-04-04 [#71555] Update project date
    [IO.kicad_sch, Mic_Conn.kicad_sch, RP2040-1.kicad_sch, RP2040-2.kicad_sch, amp.kicad_sch, audio-latency-processing-board.kicad_sch, usb.kicad_sch]
2025-04-04 [#71555] Expand sch logic areas naming
    [Mic_Conn.kicad_sch, RP2040-1.kicad_sch, amp.kicad_sch]
2025-04-04 [#71555] Make 100nF value visible
    [RP2040-1.kicad_sch, RP2040-2.kicad_sch]
2025-04-04 [#71555] Fix I2C and SPI channels overlap
    [RP2040-1.kicad_sch, RP2040-2.kicad_sch, audio-latency-processing-board.kicad_sch]
2025-04-04 [#71555] Add testpoints to unused RPI gpios
    [RP2040-1.kicad_sch, RP2040-2.kicad_sch]
2025-04-04 [#71555] Fix capacitors note
    [RP2040-1.kicad_sch, RP2040-2.kicad_sch]
2025-04-04 [#71555] Add DNP 0R to SPI MISO and MOSI lines
    [RP2040-1.kicad_sch]
2025-04-04 [#71555] Expand SPI DNP configuration
    [RP2040-1.kicad_sch]
2025-04-04 [#71555] Add TVS to Trigger IOs
    [IO.kicad_sch]
2025-04-04 [#71555] Fix USB TVS connections
    [usb.kicad_sch]
2025-04-04 [#71555] Fix USB switch enable logic
    [usb.kicad_sch]
2025-04-04 [#71555] Add 10u to USB power switches output
    [usb.kicad_sch]
2025-04-04 [#71555] Fix 22A 0R value visibility
    [usb.kicad_sch]
2025-04-04 [#71555] Change 1V8 status LED driver circuit
    [usb.kicad_sch]
2025-04-04 [#71555] Change DCDC inductors to 2u2
    [usb.kicad_sch]
2025-04-04 [#71555] Add SPI RAM to AMP's RPI
    [RP2040-2.kicad_sch]
2025-04-04 [#71555] Clear ERC
    [RP2040-2.kicad_sch]
2025-04-04 [#71555] Add NPTH and change speaker connector to JST XH
    [amp.kicad_sch, audio-latency-processing-board.kicad_sch]
2025-04-04 [#71555] Update components, start placement
    [RP2040-2.kicad_sch, amp.kicad_sch]
2025-04-04 [#71555] Align connectors
2025-04-04 [#71555] Align designators
    [RP2040-1.kicad_sch, RP2040-2.kicad_sch]
2025-04-04 [#71555] Add 100nF to MCU 1 and MCU 2 3V3 rails
    [RP2040-1.kicad_sch, RP2040-2.kicad_sch]
2025-04-04 [#71555] Fix USB inner pair swap
    [RP2040-1.kicad_sch, RP2040-2.kicad_sch]
2025-04-04 [#71555] Switch LEDs switching transistors to BC817-25W
    [RP2040-1.kicad_sch, RP2040-2.kicad_sch, usb.kicad_sch]
2025-04-04 [#71555] Bump rev to 1.1.1
    [IO.kicad_sch, Mic_Conn.kicad_sch, RP2040-1.kicad_sch, RP2040-2.kicad_sch, amp.kicad_sch, audio-latency-processing-board.kicad_sch, usb.kicad_sch]
2025-04-04 [#71555] Apply changes to the PCB
2025-04-04 [#71986] Bump rev to 1.2.0
    [IO.kicad_sch, Mic_Conn.kicad_sch, RP2040-1.kicad_sch, RP2040-2.kicad_sch, amp.kicad_sch, audio-latency-processing-board.kicad_sch, usb.kicad_sch]
2025-04-04 [#71986] Add parallel 1M to RP2040 oscilators
    [RP2040-1.kicad_sch, RP2040-2.kicad_sch]
2025-04-04 [#71986] Replace microphone-board connectors with FFC/ZIF
    [Mic_Conn.kicad_sch]
2025-04-04 [#71986] Replace AMP with MAX98357AA
    [amp.kicad_sch]
2025-04-04 [#71986] Finish sch MAX98357AA
    [amp.kicad_sch]
2025-04-04 [#71986] Remove 1V8 circuits after changing the AMP
    [Mic_Conn.kicad_sch, RP2040-1.kicad_sch, RP2040-2.kicad_sch, amp.kicad_sch, audio-latency-processing-board.kicad_sch, usb.kicad_sch]
2025-04-04 [#71986] Explode subschematics
    [amp.kicad_sch]
2025-04-04 [#71986] Place all components on board area
    [RP2040-1.kicad_sch, RP2040-2.kicad_sch, amp.kicad_sch]
2025-04-04 [#71986] Mark all connectors
    [RP2040-2.kicad_sch]
2025-04-04 [#71986] Add 4th trigger I/O
    [IO.kicad_sch, RP2040-1.kicad_sch, RP2040-2.kicad_sch, audio-latency-processing-board.kicad_sch]
2025-04-04 [#71986] Update TQFN-16 footprint
2025-04-04 [#71986] Import changes to the PCB
2025-04-04 [#71986] Add labels to AMP's config resistors
2025-04-04 [#71249] Update project name
    [IO.kicad_sch, Mic_Conn.kicad_sch, RP2040-1.kicad_sch, RP2040-2.kicad_sch, amp.kicad_sch, audio-controller-board.kicad_sch, audio-latency-processing-board.kicad_sch, usb.kicad_sch]
2025-04-04 [#71230] Replace speaker I2S ESD protection. Route speaker I2S lines
    [Mic_Conn.kicad_sch, amp.kicad_sch]
2025-04-04 [#71230] Route most of speaker MCU
    [RP2040-2.kicad_sch]
2025-04-04 [#71230] Route MCU2 USB-C connector
2025-04-04 [#71230] Route MCU1 SPI flash
2025-04-04 [#71230] Route SPI flash for MCU2
2025-04-04 [#71230] Route SPI RAM for MCU2
2025-04-04 [#71230] Route MCU1 I2S
    [Mic_Conn.kicad_sch]
2025-04-04 [#71230] Route 3V3 supply, hanging GNDs
2025-04-04 [#71230] Add support for PDM microphone
    [PDM_Mic.kicad_sch, RP2040-1.kicad_sch, audio-controller-board.kicad_sch]
2025-04-04 [#71230] Route I2S and PDM
    [PDM_Mic.kicad_sch]
2025-04-04 [#71230] Resolve non silkscreen related DRCs
2025-04-04 [#71230] Fix silkscreen
2025-04-04 [#71230] Update footprints from library
2025-04-04 [#71230] Add option to connect PDM mic directly to RP2040-0
    [PDM_Mic.kicad_sch, RP2040-1.kicad_sch, audio-controller-board.kicad_sch]
2025-04-04 [#71230] Bump rev to 1.3.0
    [IO.kicad_sch, Mic_Conn.kicad_sch, PDM_Mic.kicad_sch, RP2040-1.kicad_sch, RP2040-2.kicad_sch, amp.kicad_sch, audio-controller-board.kicad_sch, usb.kicad_sch]
2025-04-04 [#71230] Fix I2C bus indexing
    [PDM_Mic.kicad_sch]
2025-04-04 [#71230] Import components to the PCB
    [PDM_Mic.kicad_sch]
2025-04-04 [#71230] Place resistors, finalize routing and align silkscreen
2025-04-04 [#72130] Change 1V8 LDO to power from 3V3, improve power planes
    [PDM_Mic.kicad_sch]
2025-04-04 [#72130] Improve USB Routing
    [usb.kicad_sch]
2025-04-04 [#72130] Length Match SPI on RPI2 to 12.5mm
2025-04-04 [#72130] Increase internal layers clearance to 0.25mm
2025-04-04 [#72130] Move Microphone connector's plane away from pins
2025-04-04 [#72130] Increase Timestamp SPI lines spacing
2025-04-04 [#72130] Further improve SPI routing
2025-04-04 [#72130] Decrease GND plane under J12
2025-04-04 [72462] Changed vias to 0.45/0.2 mm
2025-04-04 Revision bump to 1.3.1
    [IO.kicad_sch, Mic_Conn.kicad_sch, PDM_Mic.kicad_sch, RP2040-1.kicad_sch, RP2040-2.kicad_sch, amp.kicad_sch, audio-controller-board.kicad_sch, usb.kicad_sch]
2025-04-07 [#75544] Add license and logotype
    [IO.kicad_sch, Mic_Conn.kicad_sch, PDM_Mic.kicad_sch, RP2040-1.kicad_sch, RP2040-2.kicad_sch, amp.kicad_sch, audio-controller-board.kicad_sch, usb.kicad_sch]
2025-04-11 [#75930] Change DNP configuration to PDM
    [IO.kicad_sch, Mic_Conn.kicad_sch, PDM_Mic.kicad_sch, RP2040-1.kicad_sch, RP2040-2.kicad_sch, audio-controller-board.kicad_sch, usb.kicad_sch]
2025-05-21 [#77779] Rename to audio latency tester board
    [IO.kicad_sch, Mic_Conn.kicad_sch, PDM_Mic.kicad_sch, RP2040-1.kicad_sch, RP2040-2.kicad_sch, amp.kicad_sch, audio-controller-board.kicad_sch, audio-latency-tester-board.kicad_sch]
2025-05-22 [#77860] Add stackup.csv
    [stackup.csv]
