antmicro/audio-latency-tester-board/(notices)

Notices in the files:
parts and their libraries:
License: Apache-2.0
